0x007E/lixie/Documentation/230301_Lixie_Messprotokoll/Lixie_Segment_Strom_0x0F.jpeg

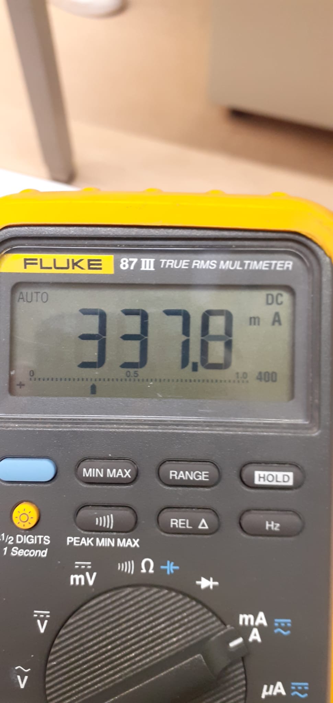
Documentation/230301_Lixie_Messprotokoll/Lixie_Segment_Strom_0x0F.jpeg
