0x007E/lixie/Datasheets-Libs/eagle_lib-master/README.md

# eagle_lib
Collection of own lib for Eagle CAD

Most of the libs comes from http://www.element14.com/community/community/cadsoft_eagle/eagle_cad_libraries WEB page
