0x007E/lixie/Documentation/Software_Doku_Zwischenspeicher.docx

Projekt „01_Lixie_Clock_ATmega16_141222“

main.c

Konstanten und Bibliotheken

Uhr Voreinstellung

Uhr Verarbeitung (Interruptgesteuert)

Timer Setup

Konstanten und Bibliotheken

Uhr Voreinstellung

Konstanten und Bibliotheken

Uhr Voreinstellung

CPU-Initialisierung

Projekt „02_Lixie_Clock_ATtiny1606“

clock.h

clock.c

Bibliotheken

Initialisierung

Projekt „02_Lixie_Clock_ATtiny1606“

spi.h

spi.c

Bibliotheken

Projekt „02_Lixie_Clock_ATtiny1606“

led.h

Led.c

Bibliotheken

LED-Initialisierung

LED-Startframe

LED-Endframe

Projekt „02_Lixie_Clock_ATtiny1606“

main.c
