0x007E/lixie/Documentation/230301_Lixie_Messprotokoll/Lixie_LED_Strom_0x01.jpeg

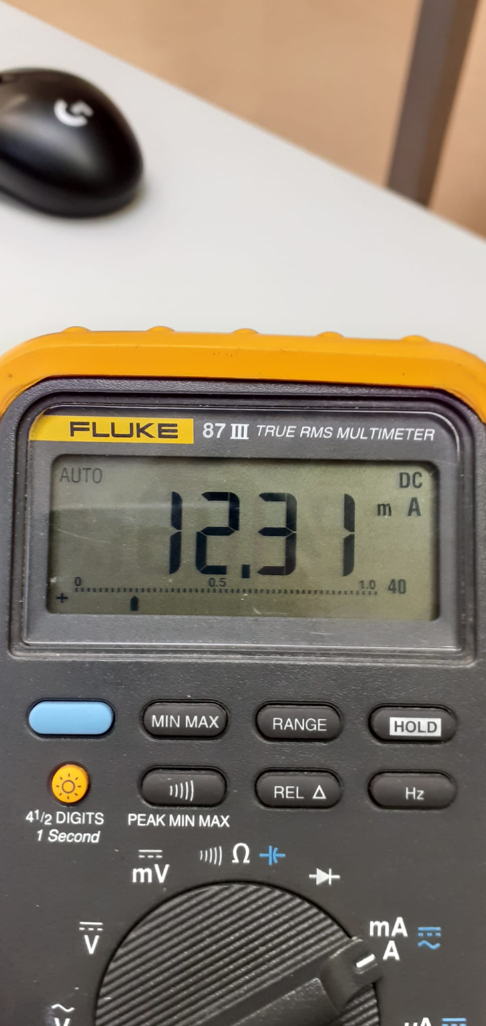
Documentation/230301_Lixie_Messprotokoll/Lixie_LED_Strom_0x01.jpeg
