0x007E/lixie/Documentation/Diagramme_Atmega16/Lixie_Structorizer/ISR_Timer1.png

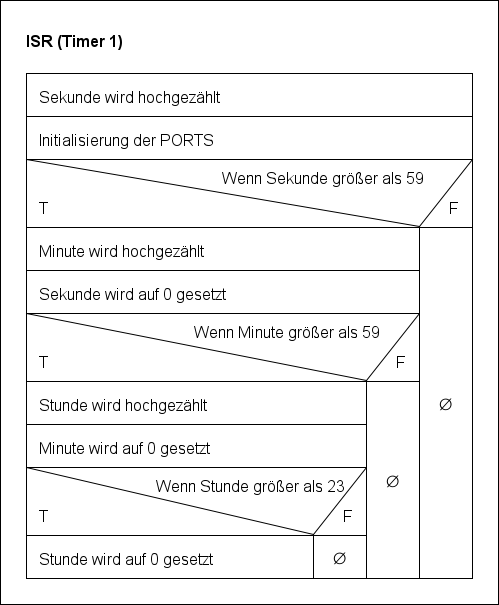
Documentation/Diagramme_Atmega16/Lixie_Structorizer/ISR_Timer1.png
