0x007E/lixie/Documentation/Diagramme_Atmega16/Lixie_Structorizer/Timer_Initialisierung_01.png

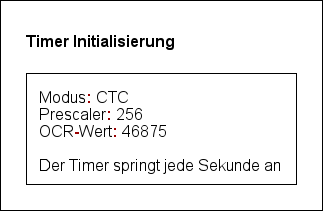
Documentation/Diagramme_Atmega16/Lixie_Structorizer/Timer_Initialisierung_01.png
