0x007E/lixie/Documentation/Diagramme_Atmega16/Lixie_Structorizer/Uhr_Datenframe_01.png

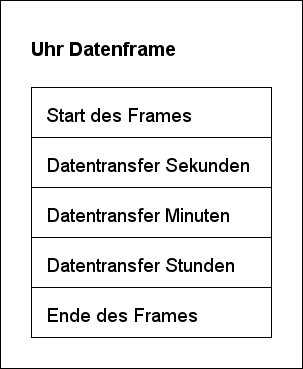
Documentation/Diagramme_Atmega16/Lixie_Structorizer/Uhr_Datenframe_01.png
