0x007E/lixie/Documentation/Diagramme_Attiny1606/Interrupt_Service_Routine.png

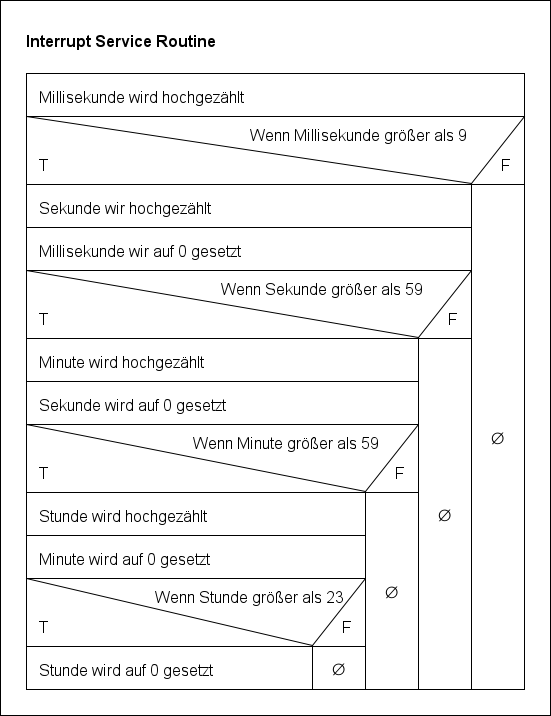
Documentation/Diagramme_Attiny1606/Interrupt_Service_Routine.png
