0x007E/lixie/Documentation/Diagramme_Attiny1606/LED_Endframe.png

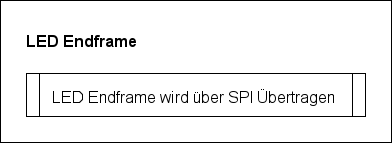
Documentation/Diagramme_Attiny1606/LED_Endframe.png
