0x007E/lixie/Documentation/Diagramme_Attiny1606/LED_Initialisierung.png

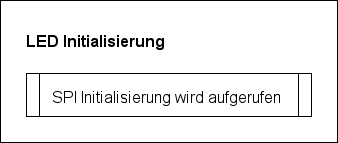
Documentation/Diagramme_Attiny1606/LED_Initialisierung.png
