0x007E/lixie/Documentation/Diagramme_Attiny1606/LED_Zeit.png

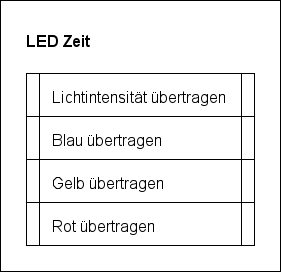
Documentation/Diagramme_Attiny1606/LED_Zeit.png
