0x007E/lixie/Documentation/Diagramme_Attiny1606/SPI_Übertragung.png

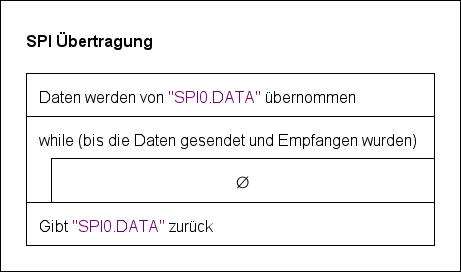
Documentation/Diagramme_Attiny1606/SPI_Übertragung.png
