0x007E/lixie/Documentation/Diagramme_Attiny1606/Takt_Initialisierung.png

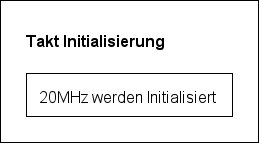
Documentation/Diagramme_Attiny1606/Takt_Initialisierung.png
