0x007E/lixie/Documentation/Diagramme_Attiny1606/Uhr_Daten.png

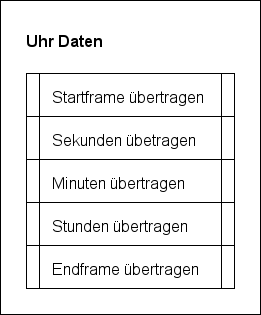
Documentation/Diagramme_Attiny1606/Uhr_Daten.png
