0x007E/lixie/Documentation/Diagramme_Attiny1606/Uhr_Datentransfer.png

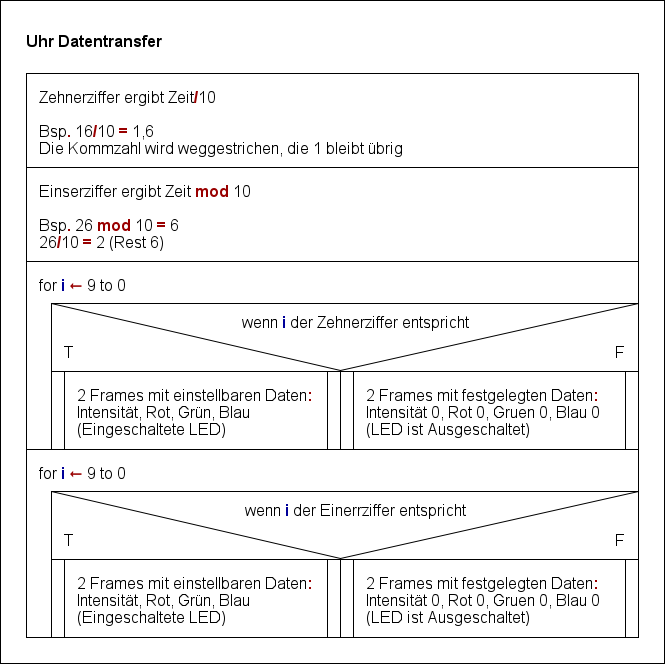
Documentation/Diagramme_Attiny1606/Uhr_Datentransfer.png
