0x007E/lixie/Datasheets-Libs/Lixie-Uhr-Bestellliste.xlsx

STÜCKLISTE |  |  |  |  |  |  |  | Höhere technische Bundeslehr- und Versuchsanstalt Rankweil
 |  |  |  |  |  |  |  | Abteilung Elektronik
Projekt: Lixie_Uhr_Segment Version: V01 22203/GAR |  |  |  |  |  | SUMME 174.14
Pos | BT-Bezeichner Designator | Stück | Benennung / Wert / Spannung | Bauform | Lieferant | Artikel / Best.Nr.: | Preis | Gesamt | Bemerkung
Leiterplatte / Printet Circuit Board / PCB
 |  |  |  |  |  |  |  | 0.000
BAUTEILE SMT / Surface Mount Technology
2 | LED RGB | 200 | APA102C | SON160P500X500X140-6N | Digikey | BL-HBGR32L-3-TRB-8 | 0.580 | 115.480 | https://www.digikey.at/de/products/detail/american-bright-optoelectronics-corporation/BL-HBGR32L-3-TRB-8/9817409
3 | C1 … C20 | 200 | 100n | C0805 | Reichelt | X7R-G0805 100N | 0.009 | 1.920 | https://www.reichelt.at/at/de/smd-vielschicht-keramikkondensator-100n-10--x7r-g0805-100n-p31879.html?r=1
4 | C21 … C24 | 40 | 100uF | C0805 | Mouser | 667-EEE-FT0J101AR | 0.392 | 15.680 | https://www.mouser.at/ProductDetail/Panasonic/EEE-FT0J101AR?qs=1Gb%2FpduDpODc%2FY5AwNOYrw%3D%3D
5 | R1 … R4 | 50 | 0R | R1206 | Conrad | 402222 - 62 | 0.150 | 7.500 | https://www.conrad.at/de/p/yageo-rc1206jr-070rl-kohleschicht-widerstand-0-smd-1206-0-25-w-0-200-ppm-1-st-tape-cut-402222.html
BAUTEILE THT / Trough Hole Technology
Ende der Stückliste
STÜCKLISTE |  |  |  |  |  |  |  | Höhere technische Bundeslehr- und Versuchsanstalt Rankweil
 |  |  |  |  |  |  |  | Abteilung Elektronik
Projekt: Lixie_Uhr_Master Version: V01 22203/GAR |  |  |  |  |  | SUMME 33.56
Pos | BT-Bezeichner Designator | Stück | Benennung / Wert / Spannung | Bauform | Lieferant | Artikel / Best.Nr.: | Preis | Gesamt | Bemerkung
Leiterplatte / Printet Circuit Board / PCB
1 |  |  |  |  |  |  |  | 0.000
BAUTEILE SMT / Surface Mount Technology
2 | U1 | 1 | ATTiny406 | SOIC127P1032X265-20N | Digikey | ATTINY406-SN-ND | 1.01 | 1.01 | https://www.digikey.at/de/products/detail/microchip-technology/ATTINY406-SN/9947552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
3 | IC1 | 1 | FT232RL | SSOP28 | ebay | nr.: 273905075025 | 2.900 | 2.900 | https://www.ebay.de/itm/273905075025?hash=item3fc603c351:g:KMEAAOSwMs9dExXM
4 | C1 | 5 | 0u1 | C0805 | Reichelt | X7R-G0805 100N | 0.009 | 0.050 | https://www.reichelt.at/at/de/smd-vielschicht-keramikkondensator-100n-10--x7r-g0805-100n-p31879.html?r=1
5 | R3, R4 | 100 | 27R | R1206 | RS-Online | 866-2776 | 0.099 | 9.900 | https://at.rs-online.com/web/p/smd-widerstande/8662776 | evtl. Magazinuer
6 | R1, R2, R7 | 50 | 330R | R0805 | RS-Online | 223-0354 | 0.060 | 3.000 | https://at.rs-online.com/web/p/smd-widerstande/2230354 | evtl. Magazinuer
7 | R5, R6 | 50 | 330R | R1206 | RS-Online | 223-2186 | 0.010 | 5.050 | https://at.rs-online.com/web/p/smd-widerstande/2232186 | evtl. Magazinuer
8 | C2, C3 | 25 | 4u7 | 153CLV-0405 | RS-Online | 708-3513 | 0.345 | 8.630 | https://at.rs-online.com/web/p/aluminium-elektrolytkondensatoren/7083513
9 | F1 | 1 | MF-SMDF200 | MF-SMDF050 | Mouser | 652-MF-SMDF200-2 | 0.480 | 0.480 | https://www.mouser.at/ProductDetail/Bourns/MF-SMDF200-2?qs=NmEazmuVvbUP9opuVlBLcQ%3D%3D
10 | U$3 | 1 | PIN4 | PIN4_P | Conrad | 1581023 - 62 | 0.400 | 0.400 | https://www.conrad.at/de/p/tru-components-stiftleiste-standard-anzahl-reihen-1-polzahl-je-reihe-5-1581023-1-st-1581023.html | evtl. Magazinuer
11 | S1 | 1 | TASTER_SMD | TASTER_SMD | Conrad | 183373 - 62 | 0.730 | 0.730 | https://www.conrad.at/de/p/mentor-1254-1004-drucktaster-12-v-dc-ac-0-05-a-1-x-aus-ein-tastend-1-st-183373.html | evtl. Magazinuer
BAUTEILE THT / Trough Hole Technology
12 | J1 | 1 | 65100516121 | 65100516121 | Mouser | 710-65100516121 | 1.410 | 1.410 | https://www.mouser.at/ProductDetail/Wurth-Elektronik/65100516121?qs=rS3zZhy2AQPLyCguT204Og%3D%3D
Ende der Stückliste
STÜCKLISTE |  |  |  |  |  |  |  | Höhere technische Bundeslehr- und Versuchsanstalt Rankweil
 |  |  |  |  |  |  |  | Abteilung Elektronik
Projekt: Lixie_Uhr_Sonstiges Version: V01 22203/GAR |  |  |  |  |  | SUMME 0.00
Pos | BT-Bezeichner Designator | Stück | Benennung / Wert / Spannung | Bauform | Lieferant | Artikel / Best.Nr.: | Preis | Gesamt | Bemerkung
Anderes
1 | Plexigläser | 80 | 34mm X 70mm X 2mm |  |  |  |  | 0.000
2 | Distanzbolzen | 4 | M3 25mm
3 | Gummifüße | 4
4 | PCB Buchse | 20 | 4 Polig
Ende der Stückliste
