0x007E/lixie/Datasheets-Libs/Bestellungen_aktuell/Best_BBG_Toner_0221.xls

Stück | Bezeichnung | Artikel Nummer | €/Einheit | Lehrer | Auftrags Nr. | € ges. exl. | € ges. incl.
0 | 10 Stk Toner CF226A 26A | CF226A | 93.01 | Raw | Magazin | 0.00 | 0.00
0 | 1 Stk Toner CE400A | CE400A | 121.04 | Raw | Magazin | 0.00 | 0.00
0 | 3 Stk Toner CE505XC | CE505XC | 102.05 | Raw | Magazin | 0.00 | 0.00
0 | Stk Toner CE412A dzt. nicht lieferbar! | CF412A | 60.55 | Raw | Magazin | 0.00 | 0.00
 |  |  |  |  |  | 0.00 | 0.00
 | Pos.2,3,4 best. 16.12.21 |  |  |  |  | 0.00 | 0.00
 |  |  |  |  |  | 0.00 | 0.00
 |  |  |  |  |  | 0.00 | 0.00
1 | Stk Toner CF360XC black | CF360XC | 139.14 | Raw | Magazin | 139.14 | 166.97
1 | Stk Toner CF363XC magenta | CF363XC | 191.62 | Raw | Magazin | 191.62 | 229.94
9 | Stk CF226A 26A black | CF226A | 80.69 | Raw | Magazin | 726.21 | 871.45
3 | Stk CF410A (black) 1x für Neyer | CF410A |  | Raw | Magazin | 0.00 | 0.00
3 | Stk CF411A (Cyan) 1x für Neyer | CF411A | 78.41 | Raw | Magazin | 235.23 | 282.28
3 | Stk CF413A Magenta) 1x für Neyer | CF413A |  | Raw | Magazin | 0.00 | 0.00
2 | Stk CE400A (black) 2xNeyer | CE400A |  | Raw | Magazin | 0.00 | 0.00
2 | Stk CE401A (Cyan) 2xNeyer | CE401A |  | Raw | Magazin | 0.00 | 0.00
2 | Stk CE402A (Yellow) 2xNeyer | CE402A |  | Raw | Magazin | 0.00 | 0.00
2 | Stk CE403A (Magenta) 2xNeyer | CE403A |  | Raw | Magazin | 0.00 | 0.00
2 | Stk CF 412A (yellow) | CF 412A |  | Raw | Magazin | 0.00 | 0.00
3 | Stk CE505XC 3xNeyer | CE505XC |  | Raw | Magazin | 0.00 | 0.00
 |  |  |  |  |  | 0.00 | 0.00
 | Pos. 10-21 best. 10.6.22 |  |  |  |  | 0.00 | 0.00
 |  |  |  |  |  | 0.00 | 0.00
 |  |  |  |  |  | 0.00 | 0.00
 |  |  |  |  |  | 0.00 | 0.00
 |  |  |  |  |  | 0.00 | 0.00
 |  |  |  |  |  | 0.00 | 0.00
 |  |  |  |  |  | 0.00 | 0.00
 |  |  |  |  |  | 0.00 | 0.00
 |  |  |  |  |  | 0.00 | 0.00
 |  |  |  |  |  | 0.00 | 0.00
 |  |  |  |  |  | 0.00 | 0.00
 |  |  |  |  |  | 0.00 | 0.00
 |  |  |  |  |  | 0.00 | 0.00
Gesamtpreis Seite 1 |  |  |  |  |  | 1292.20 | 1550.64
Stück, VE | Bezeichnung | Artikel Nummer | €/Einheit | Lehrer | Auftrags Nr. | € ges. exl. | € ges. incl.
 |  |  |  |  |  | 0.00 | 0.00
 |  |  |  |  |  | 0.00 | 0.00
 |  |  |  |  |  | 0.00 | 0.00
 |  |  |  |  |  | 0.00 | 0.00
 |  |  |  |  |  | 0.00 | 0.00
 |  |  |  |  |  | 0.00 | 0.00
 |  |  |  |  |  | 0.00 | 0.00
 |  |  |  |  |  | 0.00 | 0.00
 |  |  |  |  |  | 0.00 | 0.00
 |  |  |  |  |  | 0.00 | 0.00
 |  |  |  |  |  | 0.00 | 0.00
 |  |  |  |  |  | 0.00 | 0.00
 |  |  |  |  |  | 0.00 | 0.00
 |  |  |  |  |  | 0.00 | 0.00
 |  |  |  |  |  | 0.00 | 0.00
 |  |  |  |  |  | 0.00 | 0.00
 |  |  |  |  |  | 0.00 | 0.00
 |  |  |  |  |  | 0.00 | 0.00
 |  |  |  |  |  | 0.00 | 0.00
 |  |  |  |  |  | 0.00 | 0.00
 |  |  |  |  |  | 0.00 | 0.00
 |  |  |  |  |  | 0.00 | 0.00
 |  |  |  |  |  | 0.00 | 0.00
 |  |  |  |  |  | 0.00 | 0.00
 |  |  |  |  |  | 0.00 | 0.00
 |  |  |  |  |  | 0.00 | 0.00
 |  |  |  |  |  | 0.00 | 0.00
 |  |  |  |  |  | 0.00 | 0.00
 |  |  |  |  |  | 0.00 | 0.00
 |  |  |  |  |  | 0.00 | 0.00
 |  |  |  |  |  | 0.00 | 0.00
 |  |  |  |  |  | 0.00 | 0.00
 |  |  |  |  |  | 0.00 | 0.00
 |  |  |  |  |  | 0.00 | 0.00
Gesamtpreis Seite 1-2 |  |  |  |  |  | 1292.20 | 1550.64
Stück, VE | Bezeichnung | Artikel Nummer | €/Einheit | Lehrer | Auftrags Nr. | € ges. exl. | € ges. incl.
 |  |  |  |  |  | 0.00 | 0.00
 |  |  |  |  |  | 0.00 | 0.00
 |  |  |  |  |  | 0.00 | 0.00
 |  |  |  |  |  | 0.00 | 0.00
 |  |  |  |  |  | 0.00 | 0.00
 |  |  |  |  |  | 0.00 | 0.00
 |  |  |  |  |  | 0.00 | 0.00
 |  |  |  |  |  | 0.00 | 0.00
 |  |  |  |  |  | 0.00 | 0.00
 |  |  |  |  |  | 0.00 | 0.00
 |  |  |  |  |  | 0.00 | 0.00
 |  |  |  |  |  | 0.00 | 0.00
 |  |  |  |  |  | 0.00 | 0.00
 |  |  |  |  |  | 0.00 | 0.00
 |  |  |  |  |  | 0.00 | 0.00
 |  |  |  |  |  | 0.00 | 0.00
 |  |  |  |  |  | 0.00 | 0.00
 |  |  |  |  |  | 0.00 | 0.00
 |  |  |  |  |  | 0.00 | 0.00
 |  |  |  |  |  | 0.00 | 0.00
 |  |  |  |  |  | 0.00 | 0.00
 |  |  |  |  |  | 0.00 | 0.00
 |  |  |  |  |  | 0.00 | 0.00
 |  |  |  |  |  | 0.00 | 0.00
 |  |  |  |  |  | 0.00 | 0.00
 |  |  |  |  |  | 0.00 | 0.00
 |  |  |  |  |  | 0.00 | 0.00
 |  |  |  |  |  | 0.00 | 0.00
 |  |  |  |  |  | 0.00 | 0.00
 |  |  |  |  |  | 0.00 | 0.00
 |  |  |  |  |  | 0.00 | 0.00
 |  |  |  |  |  | 0.00 | 0.00
 |  |  |  |  |  | 0.00 | 0.00
 |  |  |  |  |  | 0.00 | 0.00
Gesamtpreis Seite 1-3 |  |  |  |  |  | 1292.20 | 1550.64
Stück, VE | Bezeichnung | Artikel Nummer | €/Einheit | Lehrer | Auftrags Nr. | € ges. exl. | € ges. incl.
 |  |  |  |  |  | 0.00 | 0.00
 |  |  |  |  |  | 0.00 | 0.00
 |  |  |  |  |  | 0.00 | 0.00
 |  |  |  |  |  | 0.00 | 0.00
 |  |  |  |  |  | 0.00 | 0.00
 |  |  |  |  |  | 0.00 | 0.00
 |  |  |  |  |  | 0.00 | 0.00
 |  |  |  |  |  | 0.00 | 0.00
 |  |  |  |  |  | 0.00 | 0.00
 |  |  |  |  |  | 0.00 | 0.00
 |  |  |  |  |  | 0.00 | 0.00
 |  |  |  |  |  | 0.00 | 0.00
 |  |  |  |  |  | 0.00 | 0.00
 |  |  |  |  |  | 0.00 | 0.00
 |  |  |  |  |  | 0.00 | 0.00
 |  |  |  |  |  | 0.00 | 0.00
 |  |  |  |  |  | 0.00 | 0.00
 |  |  |  |  |  | 0.00 | 0.00
 |  |  |  |  |  | 0.00 | 0.00
 |  |  |  |  |  | 0.00 | 0.00
 |  |  |  |  |  | 0.00 | 0.00
 |  |  |  |  |  | 0.00 | 0.00
 |  |  |  |  |  | 0.00 | 0.00
 |  |  |  |  |  | 0.00 | 0.00
 |  |  |  |  |  | 0.00 | 0.00
 |  |  |  |  |  | 0.00 | 0.00
 |  |  |  |  |  | 0.00 | 0.00
 |  |  |  |  |  | 0.00 | 0.00
 |  |  |  |  |  | 0.00 | 0.00
 |  |  |  |  |  | 0.00 | 0.00
 |  |  |  |  |  | 0.00 | 0.00
 |  |  |  |  |  | 0.00 | 0.00
 |  |  |  |  |  | 0.00 | 0.00
 |  |  |  |  |  | 0.00 | 0.00
Gesamtpreis Seite 1-4 |  |  |  |  |  | 1292.20 | 1550.64
