0x007E/lixie/Datasheets-Libs/Bestellungen_aktuell/Best_Lieferanten_0122.xls

Stück, VE | Bezeichnung | Artikel Nummer | €/Einheit | Lehrer | Auftrags Nr. | € ges. exkl. | € ges. inkl.
 | Felec Electronics Ges.m.b.H |  |  |  |  | 0.00 | 0.00
 | www.felec.at |  |  |  |  | 0.00 | 0.00
 | KdNr.: K299514 |  |  |  |  | 0.00 | 0.00
 |  |  |  |  |  | 0.00 | 0.00
3 | Rollen Etiketten für Zebra Drucker B102 x H25 2580 | 800274-105 | 18.89 | Raw | Magazin | 56.67 | 68.00
3 | Rollen Transferfolie Wachs/Harz 3200WH 110mmx74m | 03200GS11007 | 7.01 | Raw | Magazin | 21.03 | 25.24
 | best. 8.3.22/Janz geliefert |  |  |  |  | 0.00 | 0.00
 |  |  |  |  |  | 0.00 | 0.00
 | Gietech www.gie-tec.de KdNr 313691 |  |  |  |  | 0.00 | 0.00
 |  |  |  |  |  | 0.00 | 0.00
30 | m Seitenprofil Alu silber doppelt 42mm gie-tec | 122010 1000 | 12.10 | Raw | Magazin | 363.00 | 435.60
5 | m Seitenprofil 3 Alu silber natur eloxiert 60 mm | 122030 1000 | 19.40 | Raw | Magazin | 97.00 | 116.40
2 | m Seitenprofil 4 Alu silber natur eloxiert 88,3 mm | 122040 1000 | 51.40 | Raw | Magazin | 102.80 | 123.36
 | best. 19.9.22 |  |  |  |  | 0.00 | 0.00
 |  |  |  |  |  | 0.00 | 0.00
 | www.rajapack.at KdNr.: 99340890 |  |  |  |  | 0.00 | 0.00
50 | Faltbare Karton-Regalkästen RAJA, 278 x 195 x 105/147 mm | RBAC14 | 1.47 | Raw | Magazin | 73.50 | 88.20
100 | Faltbare Karton-Regalkästen RAJA, 328 x 195 x 147 mm | RBAC14B | 1.53 | lau | labor | 153.00 | 183.60
 | best./Janz gel.19.04.22 |  |  |  |  | 0.00 | 0.00
 |  |  |  |  |  | 0.00 | 0.00
 |  |  |  |  |  | 0.00 | 0.00
 | Farben Morscher |  |  |  |  | 0.00 | 0.00
10 | Montageband |  |  |  |  | 0.00 | 0.00
 | geliefert |  |  |  |  | 0.00 | 0.00
 |  |  |  |  |  | 0.00 | 0.00
 | Distrelec KdNr 9109556 bertram.janz@htl-rankweil.at |  |  |  |  | 0.00 | 0.00
500 | Stk Potenziometer 10 kOhm, liegend, PT10MV sechskant | 164-35-168 | 0.46 | Raw | Magazin | 228.30 | 273.96
 | best. 8.6.22 |  |  |  |  | 0.00 | 0.00
 |  |  |  |  |  | 0.00 | 0.00
 | Mouser KdNr: 5072741 |  |  |  |  | 0.00 | 0.00
300 | SMD-IC Attiny 13A-SSU | 556-ATTINY13A-SSUR | 0.71 | Raw | Magazin | 212.10 | 254.52
 | bei Digikey bestellt! |  |  |  |  | 0.00 | 0.00
 |  |  |  |  |  | 0.00 | 0.00
 |  |  |  |  |  | 0.00 | 0.00
Gesamtpreis Seite 1 |  |  |  |  |  | 1307.40 | 1568.88
Stück, VE | Bezeichnung | Artikel Nummer | €/Einheit | Lehrer | Auftrags Nr. | € ges. excl. | € ges. incl.
 |  |  |  |  |  | 0.00 | 0.00
 | Hager KdNr 149 |  |  |  |  | 0.00 | 0.00
 |  |  |  |  |  | 0.00 | 0.00
12 | m Rohr aus PMMA xt, opal-weiss Ø 80/74 | 200957 | 26.25 | Raw | Magazin | 315.00 | 378.00
144 | Stk Scheiben aus PMMA gs, opal-weiss Ø 80x3 Laserarbeiten |  |  |  |  | 0.00 | 0.00
1 | = 1m² Platte PMMA für die Scheiben | 200958 |  | Raw | Magazin | 0.00 | 0.00
 | nicht bestellt Rohr ist nicht lieferbar |  |  |  |  | 0.00 | 0.00
 |  |  |  |  |  | 0.00 | 0.00
 |  |  |  |  |  | 0.00 | 0.00
 | Schnetzer Wilfried |  |  |  |  | 0.00 | 0.00
500 | Print für elektronischen Würfel | 136817 | Preisanfrage | Raw | Magazin | #VALUE! | #VALUE!
 | geliefert |  |  |  |  | 0.00 | 0.00
 |  |  |  |  |  | 0.00 | 0.00
 | Rajapack KDNr.: 99340890 |  |  |  |  | 0.00 | 0.00
1 | VE = 1000 Stk Druckverschlussbeutel 80x120mm 60µ | RGP03 | 29.70 | Raw | Magazin | 29.70 | 35.64
1 | VE = 1000 Stk Druckverschlussbeutel 100x150mm 60µ | RGP04 | 42.95 | Raw | Magazin | 42.95 | 51.54
1 | VE = 1000 Stk Druckverschlussbeutel 160x220mm 60µ | RGP07 | 62.05 | Raw | Magazin | 62.05 | 74.46
 |  |  |  |  |  | 0.00 | 0.00
 |  |  |  |  |  | 0.00 | 0.00
 |  |  |  |  |  | 0.00 | 0.00
 |  |  |  |  |  | 0.00 | 0.00
 |  |  |  |  |  | 0.00 | 0.00
 |  |  |  |  |  | 0.00 | 0.00
 |  |  |  |  |  | 0.00 | 0.00
 |  |  |  |  |  | 0.00 | 0.00
 |  |  |  |  |  | 0.00 | 0.00
 |  |  |  |  |  | 0.00 | 0.00
 |  |  |  |  |  | 0.00 | 0.00
 |  |  |  |  |  | 0.00 | 0.00
 |  |  |  |  |  | 0.00 | 0.00
 |  |  |  |  |  | 0.00 | 0.00
 |  |  |  |  |  | 0.00 | 0.00
 |  |  |  |  |  | 0.00 | 0.00
 |  |  |  |  |  | 0.00 | 0.00
Gesamtpreis Seite 1-2 |  |  |  |  |  | #VALUE! | #VALUE!
Stück, VE | Bezeichnung | Artikel Nummer | €/Einheit | Lehrer | Auftrags Nr. | € ges. excl. | € ges. incl.
 |  |  |  |  |  | 0.00 | 0.00
 |  |  |  |  |  | 0.00 | 0.00
 |  |  |  |  |  | 0.00 | 0.00
 |  |  |  |  |  | 0.00 | 0.00
 |  |  |  |  |  | 0.00 | 0.00
 |  |  |  |  |  | 0.00 | 0.00
 |  |  |  |  |  | 0.00 | 0.00
 |  |  |  |  |  | 0.00 | 0.00
 |  |  |  |  |  | 0.00 | 0.00
 |  |  |  |  |  | 0.00 | 0.00
 |  |  |  |  |  | 0.00 | 0.00
 |  |  |  |  |  | 0.00 | 0.00
 |  |  |  |  |  | 0.00 | 0.00
 |  |  |  |  |  | 0.00 | 0.00
 |  |  |  |  |  | 0.00 | 0.00
 |  |  |  |  |  | 0.00 | 0.00
 |  |  |  |  |  | 0.00 | 0.00
 |  |  |  |  |  | 0.00 | 0.00
 |  |  |  |  |  | 0.00 | 0.00
 |  |  |  |  |  | 0.00 | 0.00
 |  |  |  |  |  | 0.00 | 0.00
 |  |  |  |  |  | 0.00 | 0.00
 |  |  |  |  |  | 0.00 | 0.00
 |  |  |  |  |  | 0.00 | 0.00
 |  |  |  |  |  | 0.00 | 0.00
 |  |  |  |  |  | 0.00 | 0.00
 |  |  |  |  |  | 0.00 | 0.00
 |  |  |  |  |  | 0.00 | 0.00
 |  |  |  |  |  | 0.00 | 0.00
 |  |  |  |  |  | 0.00 | 0.00
 |  |  |  |  |  | 0.00 | 0.00
 |  |  |  |  |  | 0.00 | 0.00
 |  |  |  |  |  | 0.00 | 0.00
 |  |  |  |  |  | 0.00 | 0.00
Gesamtpreis Seite 1-3 |  |  |  |  |  | #VALUE! | #VALUE!
Stück, VE | Bezeichnung | Artikel Nummer | €/Einheit | Lehrer | Auftrags Nr. | € ges. excl. | € ges. incl.
 |  |  |  |  |  | 0.00 | 0.00
 |  |  |  |  |  | 0.00 | 0.00
 |  |  |  |  |  | 0.00 | 0.00
 |  |  |  |  |  | 0.00 | 0.00
 |  |  |  |  |  | 0.00 | 0.00
 |  |  |  |  |  | 0.00 | 0.00
 |  |  |  |  |  | 0.00 | 0.00
 |  |  |  |  |  | 0.00 | 0.00
 |  |  |  |  |  | 0.00 | 0.00
 |  |  |  |  |  | 0.00 | 0.00
 |  |  |  |  |  | 0.00 | 0.00
 |  |  |  |  |  | 0.00 | 0.00
 |  |  |  |  |  | 0.00 | 0.00
 |  |  |  |  |  | 0.00 | 0.00
 |  |  |  |  |  | 0.00 | 0.00
 |  |  |  |  |  | 0.00 | 0.00
 |  |  |  |  |  | 0.00 | 0.00
 |  |  |  |  |  | 0.00 | 0.00
 |  |  |  |  |  | 0.00 | 0.00
 |  |  |  |  |  | 0.00 | 0.00
 |  |  |  |  |  | 0.00 | 0.00
 |  |  |  |  |  | 0.00 | 0.00
 |  |  |  |  |  | 0.00 | 0.00
 |  |  |  |  |  | 0.00 | 0.00
 |  |  |  |  |  | 0.00 | 0.00
 |  |  |  |  |  | 0.00 | 0.00
 |  |  |  |  |  | 0.00 | 0.00
 |  |  |  |  |  | 0.00 | 0.00
 |  |  |  |  |  | 0.00 | 0.00
 |  |  |  |  |  | 0.00 | 0.00
 |  |  |  |  |  | 0.00 | 0.00
 |  |  |  |  |  | 0.00 | 0.00
 |  |  |  |  |  | 0.00 | 0.00
 |  |  |  |  |  | 0.00 | 0.00
Gesamtpreis Seite 1-4 |  |  |  |  |  | #VALUE! | #VALUE!
