0x007E/lixie/Hardware/Gehäuse/DD/Lixie-Uhr_Desing.SLDASM

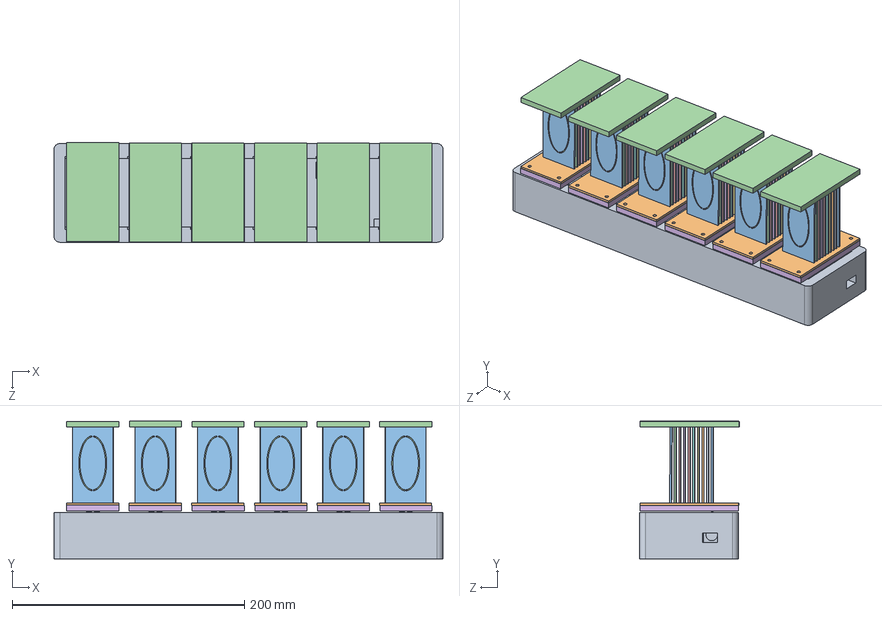
[picture p50: CAD file, 2023-03-17]
Hardware/Gehäuse/DD/Lixie-Uhr_Desing.SLDASM
335.0 x 118.4 x 85.7 mm
Akpinar_4AFEL_Lixie-Uhr-Unterseite
Akpinar_4AFEL_Zwischenplatte x 6
Akpinar_4AFEL_PlexiGlas0 x 6
Akpinar_4AFEL_PlexiGlas1 x 6
Akpinar_4AFEL_PlexiGlas2 x 6
Akpinar_4AFEL_PlexiGlas3 x 6
Akpinar_4AFEL_PlexiGlas6 x 6
Akpinar_4AFEL_PlexiGlas5 x 6
Akpinar_4AFEL_PlexiGlas8 x 6
Akpinar_4AFEL_PlexiGlas7 x 6
Akpinar_4AFEL_PlexiGlas9 x 6
Akpinar_4AFEL_Deckel x 6
Akpinar_4AFEL_PlexiGlas4 x 6
Akpinar_4AFEL_Plexiglas-Einsteckplatte x 6
