0x007E/lixie/Hardware/Gehäuse/DD/Akpinar_4AFEL_Lixie-Uhr-Unterseite.SLDPRT

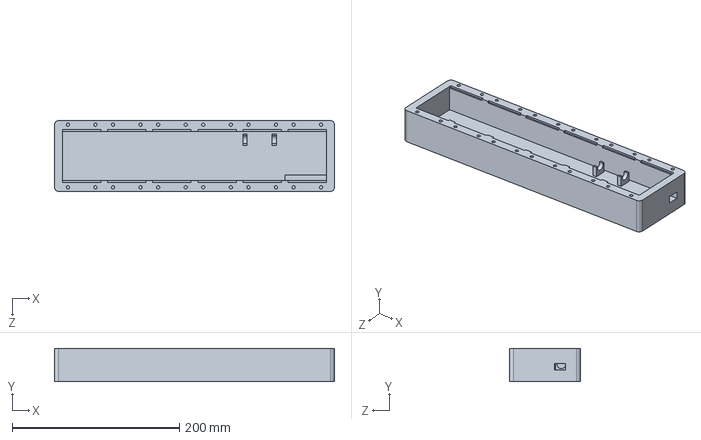
[picture p52: CAD file, 2023-03-07]
Hardware/Gehäuse/DD/Akpinar_4AFEL_Lixie-Uhr-Unterseite.SLDPRT
335.0 x 40.0 x 85.0 mm
