0x007E/lixie/Hardware/Gehäuse/DD/Akpinar_4AFEL_Deckel.SLDPRT

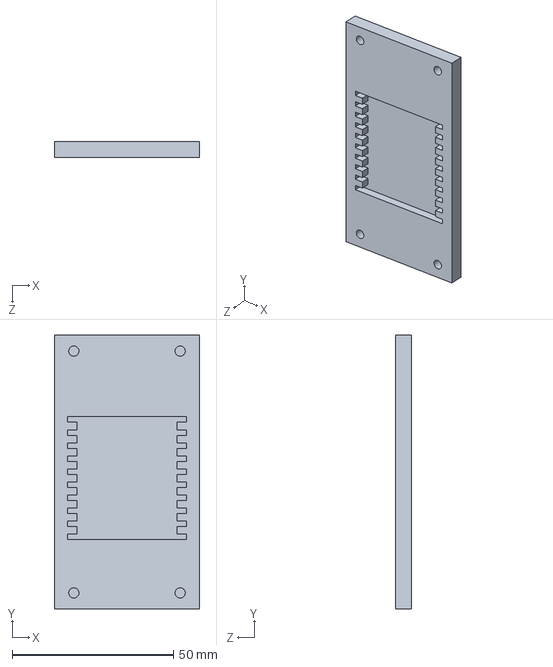
[picture p53: CAD file, 2023-02-23]
Hardware/Gehäuse/DD/Akpinar_4AFEL_Deckel.SLDPRT
45.0 x 85.0 x 5.00 mm
