0x007E/lixie/Hardware/Gehäuse/DD/Akpinar_4AFEL_PlexiGlas7.SLDPRT

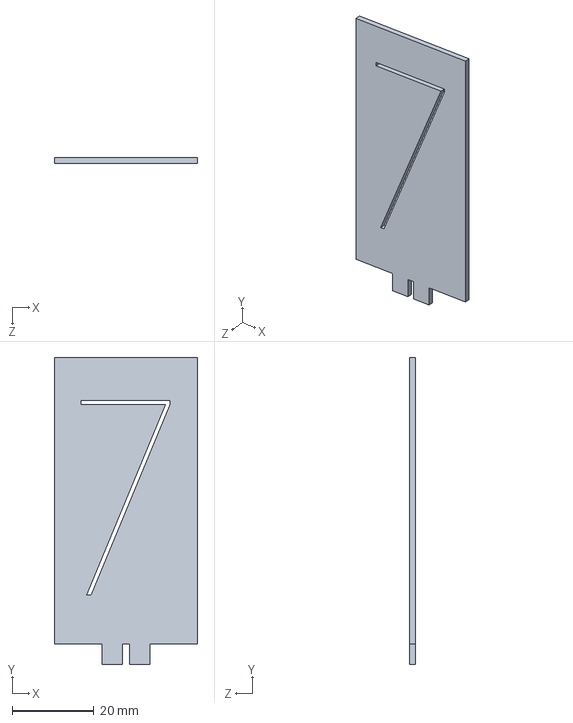
[picture p54: CAD file, 2023-02-08]
Hardware/Gehäuse/DD/Akpinar_4AFEL_PlexiGlas7.SLDPRT
35.0 x 75.0 x 1.50 mm
