0x007E/lixie/Hardware/Gehäuse/DD/Akpinar_4AFEL_PlexiGlas5.SLDPRT

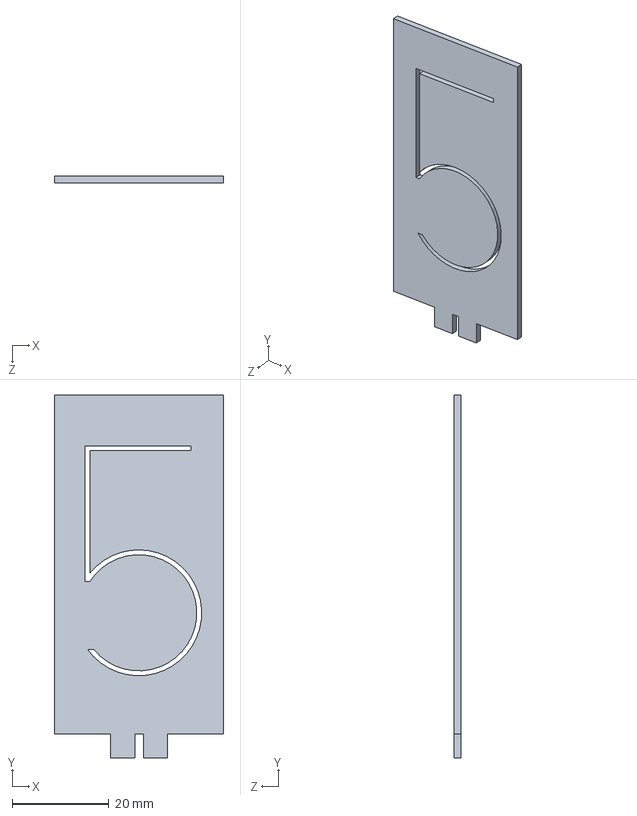
[picture p55: CAD file, 2023-02-08]
Hardware/Gehäuse/DD/Akpinar_4AFEL_PlexiGlas5.SLDPRT
35.0 x 75.0 x 1.50 mm
