0x007E/lixie/Hardware/Gehäuse/DD/Akpinar_4AFEL_Zwischenplatte.SLDPRT

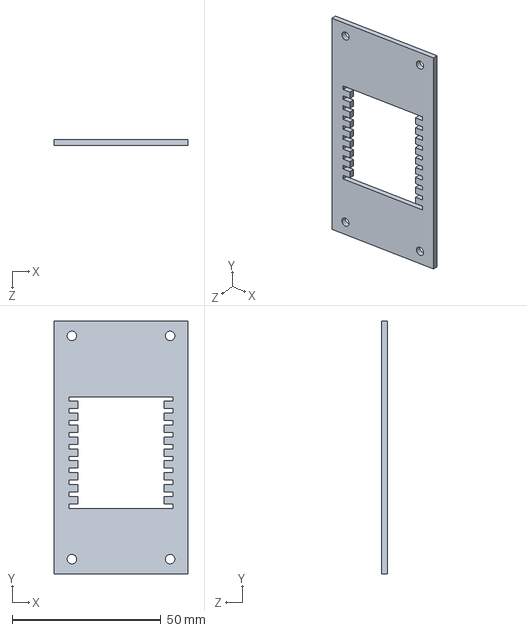
[picture p56: CAD file, 2023-02-05]
Hardware/Gehäuse/DD/Akpinar_4AFEL_Zwischenplatte.SLDPRT
45.0 x 85.0 x 2.00 mm
