0x007E/lixie/Hardware/Gehäuse/DD/Akpinar_4AFEL_PlexiGlas-Neutral2.SLDPRT

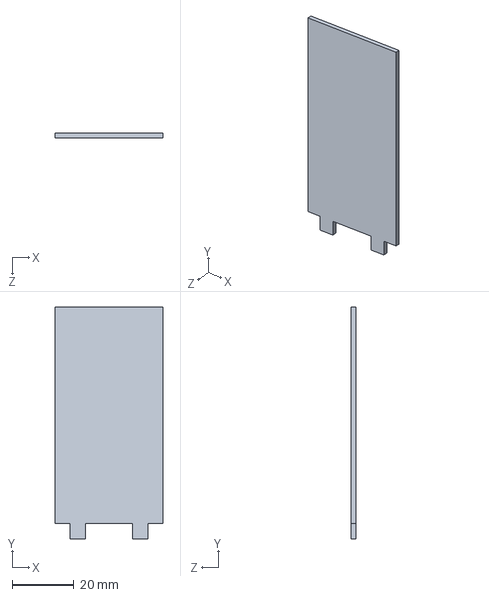
[picture p57: CAD file, 2023-02-05]
Hardware/Gehäuse/DD/Akpinar_4AFEL_PlexiGlas-Neutral2.SLDPRT
35.0 x 75.0 x 1.50 mm
