0x007E/lixie/Hardware/Gehäuse/DD/Akpinar_4AFEL_Plexiglas-Einsteckplatte.SLDPRT

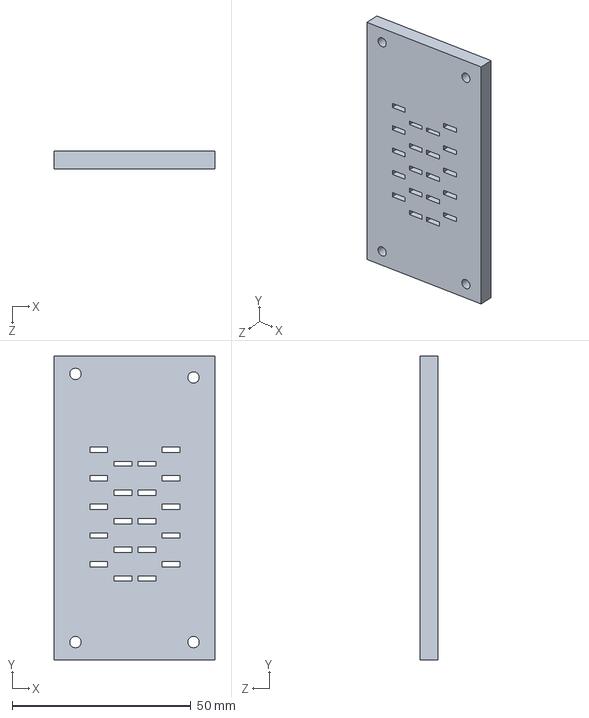
[picture p58: CAD file, 2023-02-05]
Hardware/Gehäuse/DD/Akpinar_4AFEL_Plexiglas-Einsteckplatte.SLDPRT
45.0 x 85.0 x 5.00 mm
