0x007E/lixie/(list of files, cad)

Other CAD files:
Hardware/Gehäuse/DD/Akpinar_4AFEL_PlexiGlas4.SLDPRT
Hardware/Gehäuse/DD/Akpinar_4AFEL_PlexiGlas2.SLDPRT
Hardware/Gehäuse/DD/Akpinar_4AFEL_PlexiGlas6.SLDPRT
Hardware/Gehäuse/DD/Akpinar_4AFEL_PlexiGlas3.SLDPRT
Hardware/Gehäuse/DD/Akpinar_4AFEL_PlexiGlas8.SLDPRT
Hardware/Gehäuse/DD/Akpinar_4AFEL_PlexiGlas9.SLDPRT
Hardware/Gehäuse/DD/Akpinar_4AFEL_PlexiGlas0.SLDPRT
Hardware/Gehäuse/DD/Akpinar_4AFEL_PlexiGlas1.SLDPRT
Hardware/Gehäuse/DD/Akpinar_4AFEL_PlexiGlas-Neutral.SLDPRT
