0x007E/lixie/PCB/Master/Gerber-Files/Lixie_Master.brd

## EAGLE design PCB/Master/Gerber-Files/Lixie_Master.brd (2023-03-09)

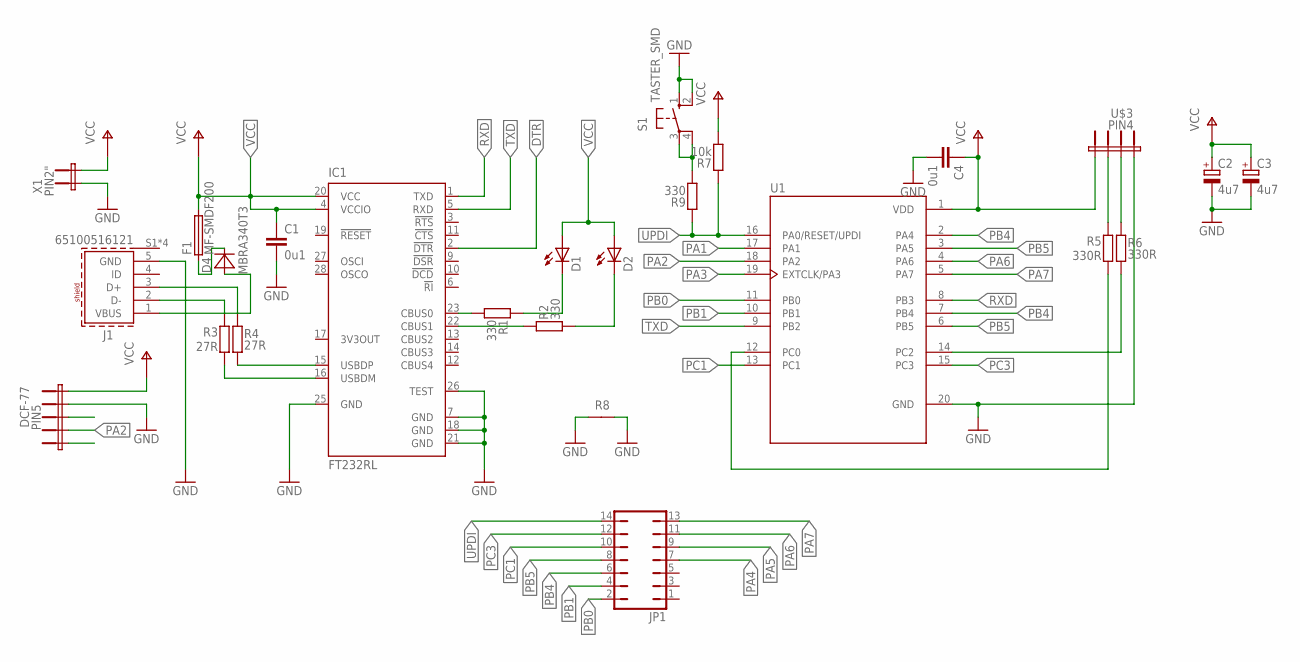
[picture p59: schematic Lixie_Master.sch]

Parts:
C1, C4: 0u1; C0805
C2, C3: 4u7; 153CLV-0405
D1, D2: LED1206; 1206
D4: MBRA340T3; SMA
DCF-77: PIN5
F1: MF-SMDF200; MF-SMDF050
IC1: FT232RL; SSOP28
J1: 65100516121
JP1: JP7Q
R1, R2, R9: 330; R0805
R3, R4: 27R; R1206
R5, R6: 330R; R1206
R7: 10k; R0805
R8: R0/10
S1: TASTER_SMD
U1: ATTINY-406SN; SOIC127P1032X265-20N
U$3: PIN4; PIN4_P
X1: PIN2"; PIN2

Connections:
DTR: IC1.2 (!DTR)
GND: C1.2, C2.-, C3.-, C4.2, DCF-77.4, IC1.7 (GND), IC1.18 (GND), IC1.21 (GND), IC1.25 (GND), IC1.26 (TEST), J1.5 (GND), R8.1, R8.2, S1.1 (S), S1.2 (S1), U1.20 (GND), U$3.4, X1.P$2 (KL1)
unnamed: J1.3 (D+), R4.2
unnamed: IC1.16 (USBDM), R3.1
unnamed: IC1.23 (CBUS0), R1.1
unnamed: J1.2 (D-), R3.2
unnamed: D1.C, R1.2
unnamed: IC1.22 (CBUS1), R2.2
unnamed: D2.C, R2.1
unnamed: R5.1, U1.12 (PC0)
unnamed: R6.1, U1.14 (PC2)
unnamed: IC1.15 (USBDP), R4.1
unnamed: D4.C, F1.1
unnamed: R5.2, U$3.2
unnamed: R6.2, U$3.3
unnamed: D4.A, J1.1 (VBUS)
unnamed: R9.1, S1.3, S1.4 (P1)
PA1: U1.17 (PA1)
PA2: DCF-77.2, U1.18 (PA2)
PA3: U1.19 (EXTCLK/PA3)
PA4: JP1.7
PA5: JP1.9
PA6: JP1.11, U1.4 (PA6)
PA7: JP1.13, U1.5 (PA7)
PB0: JP1.2, U1.11 (PB0)
PB1: JP1.4, U1.10 (PB1)
PB4: JP1.6, U1.2 (PA4), U1.7 (PB4)
PB5: JP1.8, U1.3 (PA5), U1.6 (PB5)
PC1: JP1.10, U1.13 (PC1)
PC3: JP1.12, U1.15 (PC3)
RXD: IC1.1 (TXD), U1.8 (PB3)
TXD: IC1.5 (RXD), U1.9 (PB2)
UPDI: JP1.14, R7.2, R9.2, U1.16 (PA0/RESET/UPDI)
VCC: C1.1, C2.+, C3.+, C4.1, D1.A, D2.A, DCF-77.5, F1.2, IC1.4 (VCCIO), IC1.20 (VCC), R7.1, U1.1 (VDD), U$3.1, X1.P$3 (KL2)

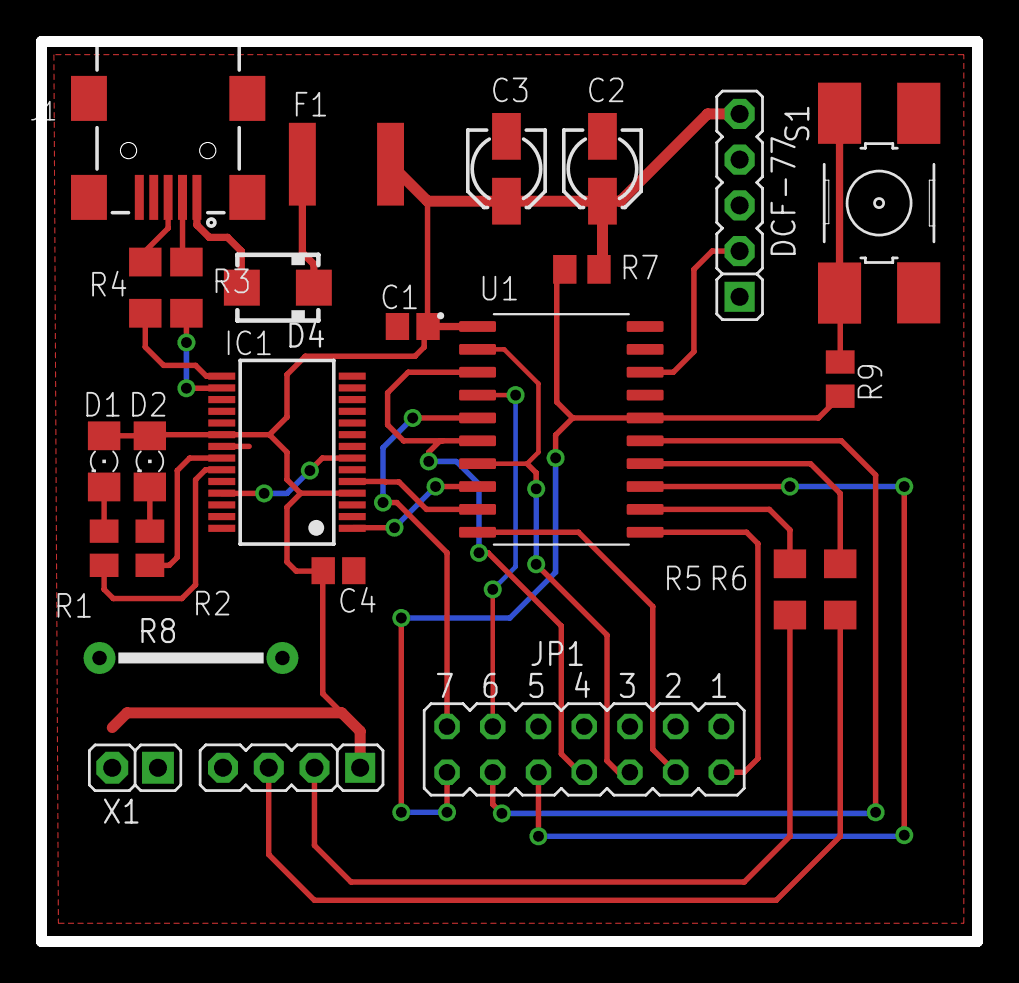
[picture p60: board Lixie_Master.brd from above]

Board: 2 copper layers, 52.0 x 50.0 mm, 25 parts (0 on the bottom side), 29 nets.
