0x007E/lixie/PCB/Slave/Lixieuhr-Segment.brd

## EAGLE design PCB/Slave/Lixieuhr-Segment.brd (2023-01-16)

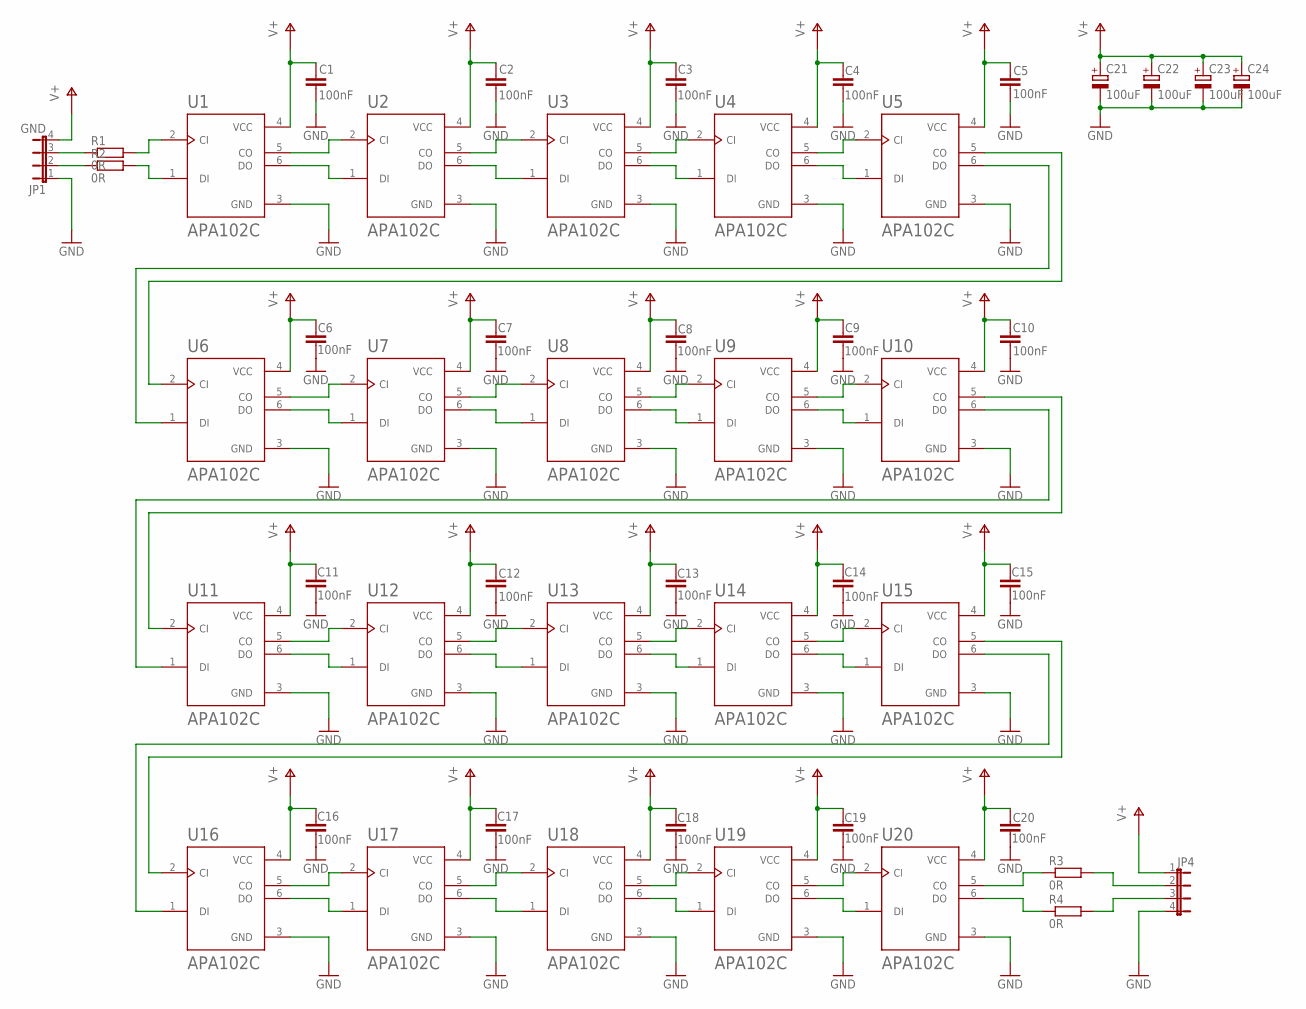
[picture p61: schematic Lixieuhr-Segment.sch]

Parts:
C1, C2, C3, C4, C5, C6, C7, C8, C9, C10, C11, C12, C13, C14, C15, C16, C17, C18, C19, C20: 100nF; C0805
C21, C22, C23, C24: 100uF; 153CLV-0405
JP1: GND; JP4
JP4: JP4E; JP4
R1, R2, R3, R4: 0R; R1206
U1, U2, U3, U4, U5, U6, U7, U8, U9, U10, U11, U12, U13, U14, U15, U16, U17, U18, U19, U20: APA102C; SON160P500X500X140-6N

Connections:
GND: C1.1, C2.1, C3.1, C4.1, C5.1, C6.1, C7.1, C8.1, C9.1, C10.1, C11.1, C12.1, C13.1, C14.1, C15.1, C16.1, C17.1, C18.1, C19.1, C20.1, C21.-, C22.-, C23.-, C24.-, JP1.1, JP4.4, U1.3 (GND), U2.3 (GND), U3.3 (GND), U4.3 (GND), U5.3 (GND), U6.3 (GND), U7.3 (GND), U8.3 (GND), U9.3 (GND), U10.3 (GND), U11.3 (GND), U12.3 (GND), U13.3 (GND), U14.3 (GND), U15.3 (GND), U16.3 (GND), U17.3 (GND), U18.3 (GND), U19.3 (GND), U20.3 (GND)
unnamed: U1.5 (CO), U2.2 (CI)
unnamed: U2.5 (CO), U3.2 (CI)
unnamed: U3.5 (CO), U4.2 (CI)
unnamed: U4.5 (CO), U5.2 (CI)
unnamed: R2.2, U1.1 (DI)
unnamed: U6.5 (CO), U7.2 (CI)
unnamed: U7.5 (CO), U8.2 (CI)
unnamed: U8.5 (CO), U9.2 (CI)
unnamed: U9.5 (CO), U10.2 (CI)
unnamed: U1.6 (DO), U2.1 (DI)
unnamed: U2.6 (DO), U3.1 (DI)
unnamed: U3.6 (DO), U4.1 (DI)
unnamed: U4.6 (DO), U5.1 (DI)
unnamed: JP1.2, R2.1
unnamed: U9.6 (DO), U10.1 (DI)
unnamed: U6.6 (DO), U7.1 (DI)
unnamed: U7.6 (DO), U8.1 (DI)
unnamed: U8.6 (DO), U9.1 (DI)
unnamed: U5.5 (CO), U6.2 (CI)
unnamed: R1.2, U1.2 (CI)
unnamed: U10.5 (CO), U11.2 (CI)
unnamed: U10.6 (DO), U11.1 (DI)
unnamed: U11.5 (CO), U12.2 (CI)
unnamed: U12.5 (CO), U13.2 (CI)
unnamed: U13.5 (CO), U14.2 (CI)
unnamed: U14.5 (CO), U15.2 (CI)
unnamed: U16.5 (CO), U17.2 (CI)
unnamed: U17.5 (CO), U18.2 (CI)
unnamed: U18.5 (CO), U19.2 (CI)
unnamed: U19.5 (CO), U20.2 (CI)
unnamed: U11.6 (DO), U12.1 (DI)
unnamed: U12.6 (DO), U13.1 (DI)
unnamed: U13.6 (DO), U14.1 (DI)
unnamed: U14.6 (DO), U15.1 (DI)
unnamed: JP1.3, R1.1
unnamed: U19.6 (DO), U20.1 (DI)
unnamed: U16.6 (DO), U17.1 (DI)
unnamed: U17.6 (DO), U18.1 (DI)
unnamed: U18.6 (DO), U19.1 (DI)
unnamed: R3.1, U20.5 (CO)
unnamed: JP4.2, R3.2
unnamed: JP4.3, R4.2
unnamed: R4.1, U20.6 (DO)
unnamed: U5.6 (DO), U6.1 (DI)
unnamed: U15.5 (CO), U16.2 (CI)
unnamed: U15.6 (DO), U16.1 (DI)
V+: C1.2, C2.2, C3.2, C4.2, C5.2, C6.2, C7.2, C8.2, C9.2, C10.2, C11.2, C12.2, C13.2, C14.2, C15.2, C16.2, C17.2, C18.2, C19.2, C20.2, C21.+, C22.+, C23.+, C24.+, JP1.4, JP4.1, U1.4 (VCC), U2.4 (VCC), U3.4 (VCC), U4.4 (VCC), U5.4 (VCC), U6.4 (VCC), U7.4 (VCC), U8.4 (VCC), U9.4 (VCC), U10.4 (VCC), U11.4 (VCC), U12.4 (VCC), U13.4 (VCC), U14.4 (VCC), U15.4 (VCC), U16.4 (VCC), U17.4 (VCC), U18.4 (VCC), U19.4 (VCC), U20.4 (VCC)

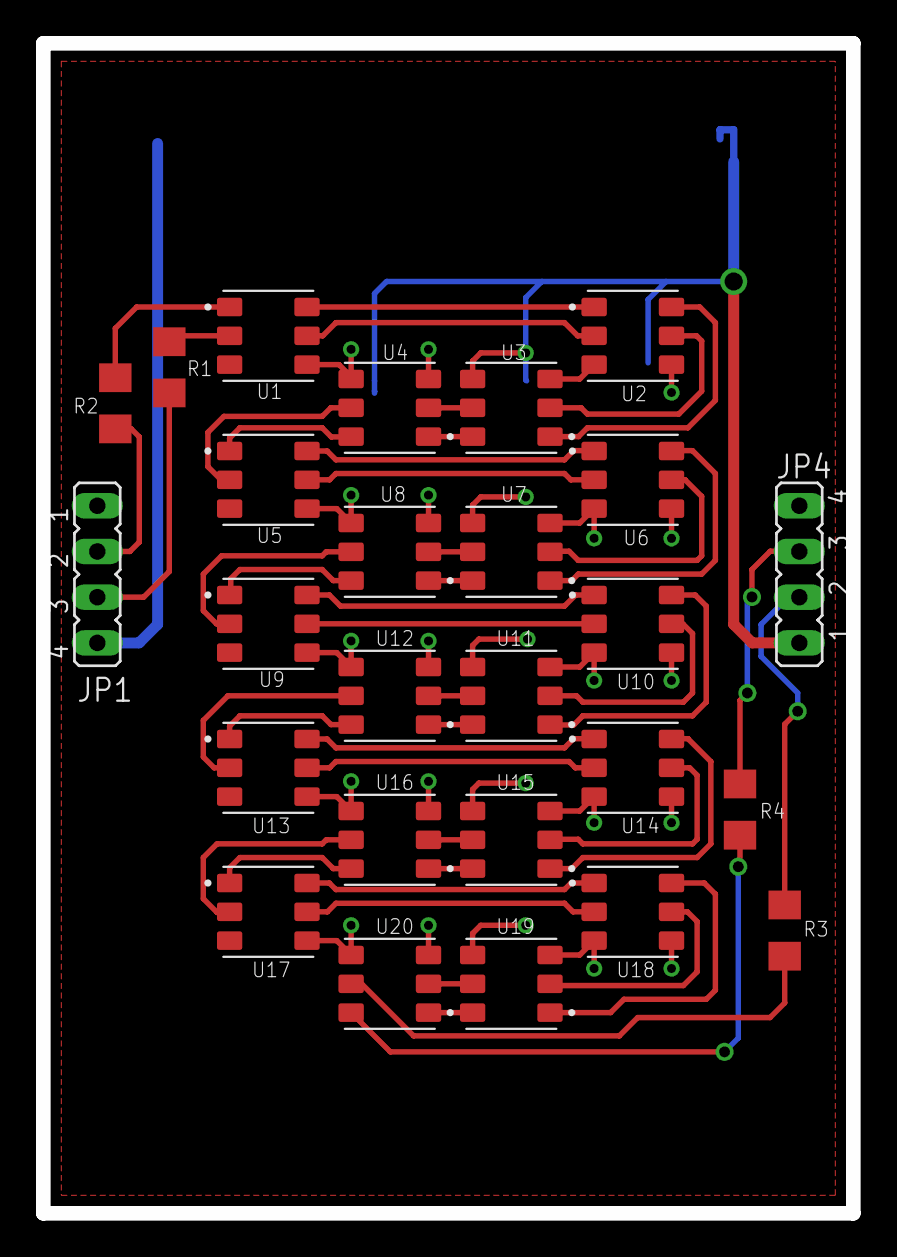
[picture p62: board Lixieuhr-Segment.brd from above]

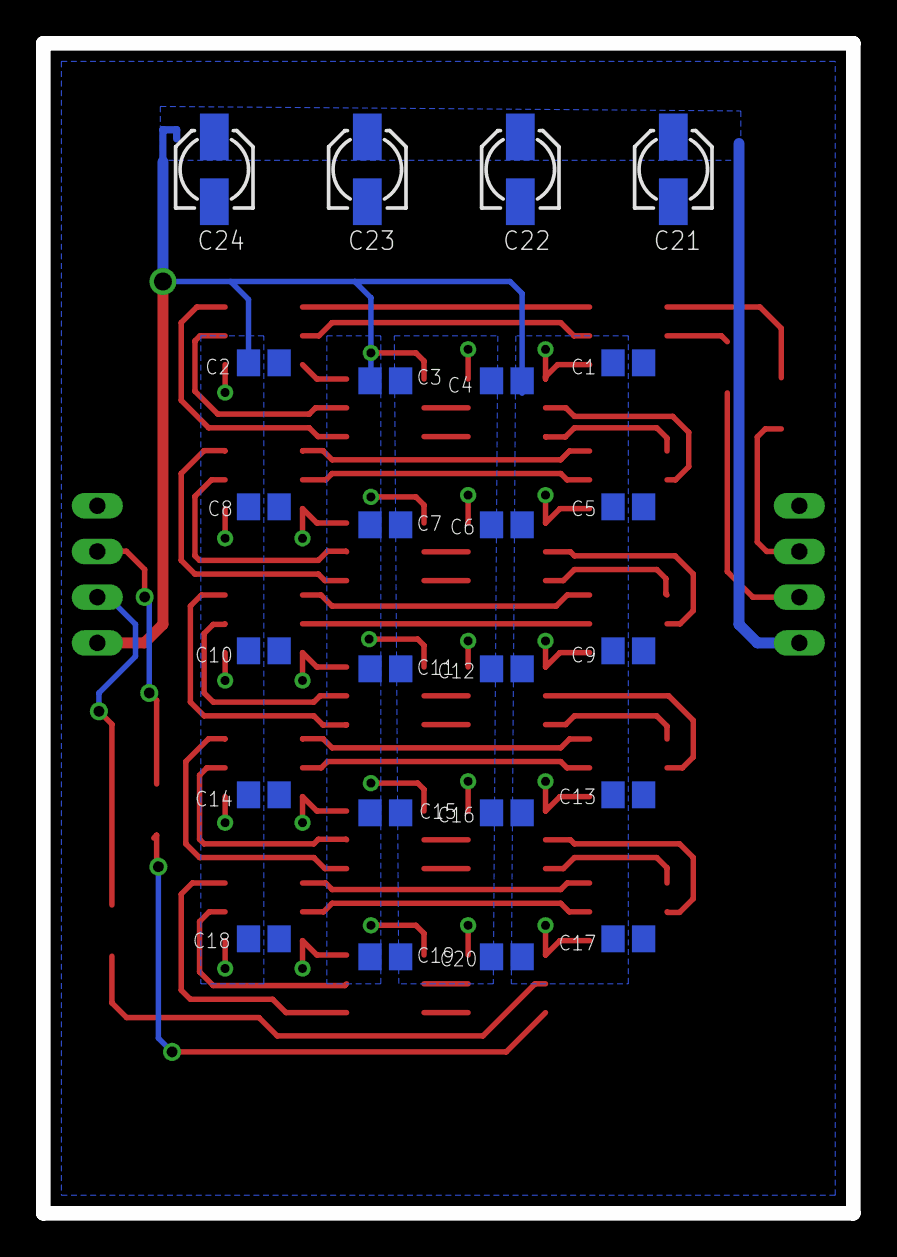
[picture p63: board Lixieuhr-Segment.brd from below]

Board: 2 copper layers, 45.0 x 65.0 mm, 50 parts (24 on the bottom side), 48 nets.
