0x007E/lixie/(commit log)

2022-12-02 Schaltpläne V02
    [Lixieuhr-Segment.brd, Lixieuhr-Segment.sch, Lixieuhr_Master.brd, Lixieuhr_Master.sch]
2022-12-04 Gerber Files
    [Lixieuhr-Segment.GBL, Lixieuhr-Segment.GBO, Lixieuhr-Segment.GBP, Lixieuhr-Segment.GBS, Lixieuhr-Segment.GKO, Lixieuhr-Segment.GTL, Lixieuhr-Segment.GTO, Lixieuhr-Segment.GTP]
2022-12-12 Leiterplatten V05
    [Lixie_Master.brd, Lixieuhr-Segment.brd]
2022-12-13 LED Values
2022-12-14 KiCad Files
2022-12-14 Added Time Settings via UART
2022-12-22 Lixie Bestellliste Update
    [Lixie-Uhr-Bestellliste.xlsx]
2022-12-24 Update Bestellung
    [Best_Conrad_1522.xls, Best_Digi_Key_1422.xls, Best_Mouser_0122.xls, Best_RS_3822.xls, Best_Reichelt_0822.xls, Lixie-Uhr-Bestellliste.xlsx]
2023-01-08 Gehäuse_aktuell
    [Akpinar_4AFEL_Lixie-Uhr-Unterseite.SLDPRT, Akpinar_4AFEL_Teil1.SLDPRT, Akpinar_4AFEL_Teil2.SLDPRT]
2023-02-01 SPI Update
2023-02-01 Struktogramm Update
    ISR und Datenstransfer Struktogramm Update
2023-02-05 Usb Anschluss
    [Akpinar_4AFEL_Lixie-Uhr-Unterseite.SLDPRT]
2023-02-23 Optimierung von Gehäuse und 3D printerstellung
    [Akpinar_4AFEL_Deckel.SLDPRT, Akpinar_4AFEL_Lixie-Uhr-Unterseite.SLDPRT]
2023-03-01 Firmware Atmega16 Update (Clock Fix)
    Bug Fixes
    [Lixie-Uhr-Bestellliste.xlsx]
2023-03-03 Firmware Update
    Attiny Firmware Update
    -SPI
    -Clock
2023-03-15 Firmware Update
    -Auf der Platine wurden TxD und RxD vertauscht
    -Neue Platinen wurden Bestellt
