0x007E/lixie/(notices)

Notices in the files:
parts and their libraries:
SOIC127P1032X265-20N: © 2018 Microchip Technology Inc. Datasheet Preliminary DS40001976A-page 1
